yoonkyoungsong/2017-Strain-Gauge-Measurement-Circuit/Filter-PSpiceFiles/SCHEMATIC1/Adder2_Filter/Adder2_Filter.cir

** Profile: "SCHEMATIC1-Adder2_Filter"  [ C:\Users\YoonKyoung\Filter-PSpiceFiles\SCHEMATIC1\Adder2_Filter.sim ] 

** Creating circuit file "Adder2_Filter.cir" 
** WARNING: THIS AUTOMATICALLY GENERATED FILE MAY BE OVERWRITTEN BY SUBSEQUENT SIMULATIONS

*Libraries: 
* Profile Libraries :
* Local Libraries :
* From [PSPICE NETLIST] section of C:\Users\YoonKyoung\AppData\Roaming\SPB_Data\cdssetup\OrCAD_PSpice\17.2.0\PSpice.ini file:
.lib "nomd.lib" 

*Analysis directives: 
.TRAN  0 1ms 0 
.OPTIONS ADVCONV
.PROBE64 V(alias(*)) I(alias(*)) W(alias(*)) D(alias(*)) NOISE(alias(*)) 
.INC "..\SCHEMATIC1.net" 


.END
